Nandhini1github/ACC-and-LKA-using-3-Ultrasonic-Sensors-and-Arduino-on-RC-car/README.md

# ACC-and-LKA-using-3-Ultrasonic-Sensors-and-Arduino-on-RC-car
Calibration and Sensor Fusion using Arduino and MATLAB
