Nandhini1github/ACC-and-LKA-using-3-Ultrasonic-Sensors-and-Arduino-on-RC-car/(commit log)

2026-02-03 Create Kalman Filter -> Calibration
2026-02-05 Create Calibration -> Kalman Filter
2026-02-05 Update Calibration -> Kalman Filter
