Nandhini1github/ACC-and-LKA-using-3-Ultrasonic-Sensors-and-Arduino-on-RC-car/Videos/IMG_0248.jpeg

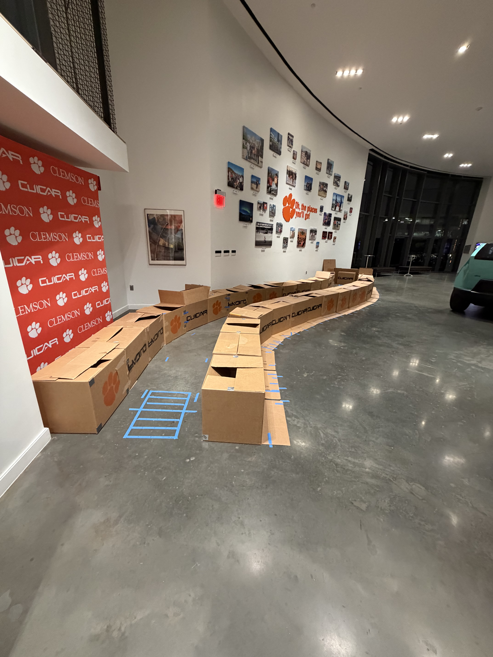
Videos/IMG_0248.jpeg
